RatchanonNRS/yaman_capstone/robot_ws/src/agv/meshes/link_R.STL

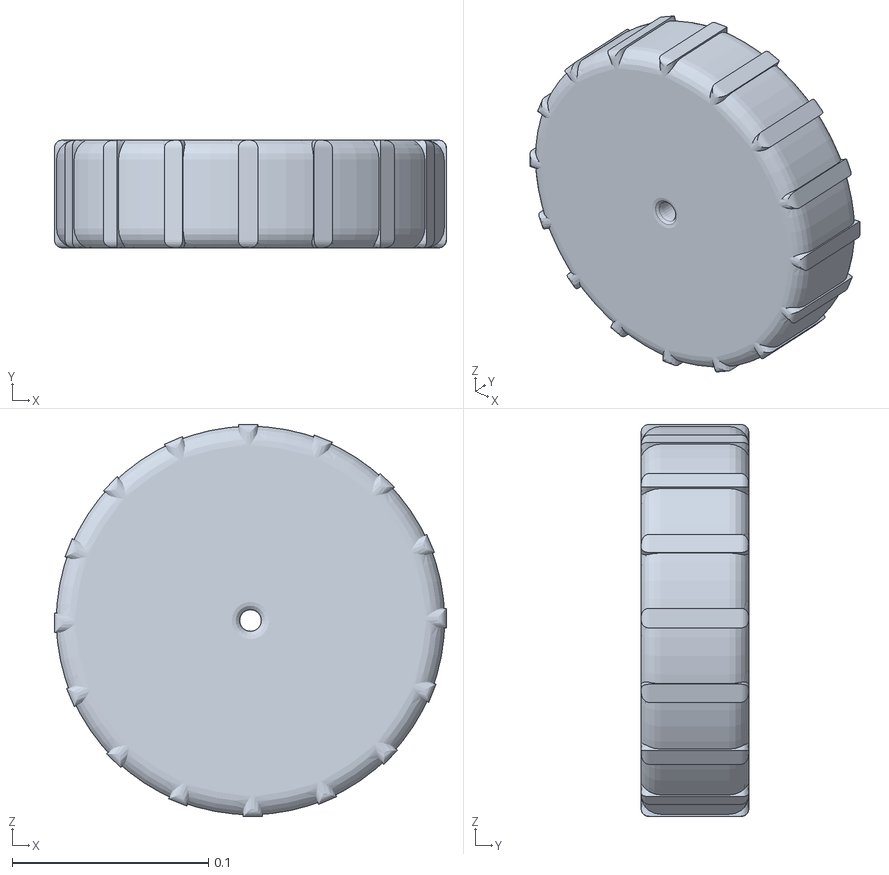
[picture p1: CAD file, 2026-03-16]
robot_ws/src/agv/meshes/link_R.STL
0.2 x 0.055 x 0.2
