RatchanonNRS/yaman_capstone/robot_ws/src/agv/meshes/LInk_lidar.STL

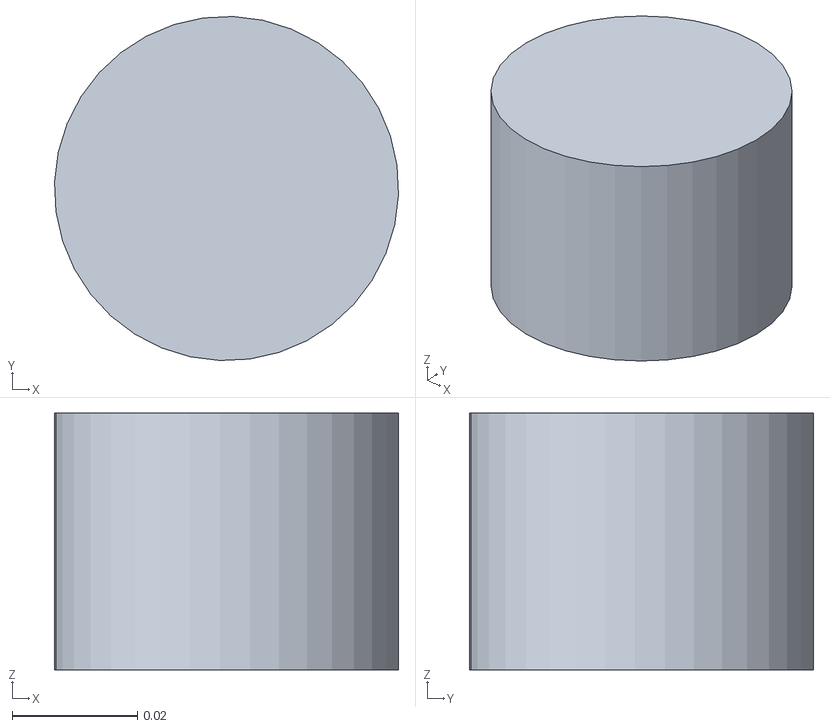
[picture p2: CAD file, 2026-03-16]
robot_ws/src/agv/meshes/LInk_lidar.STL
0.055 x 0.055 x 0.041
