RatchanonNRS/yaman_capstone/robot_ws/src/agv/meshes/base_link.STL

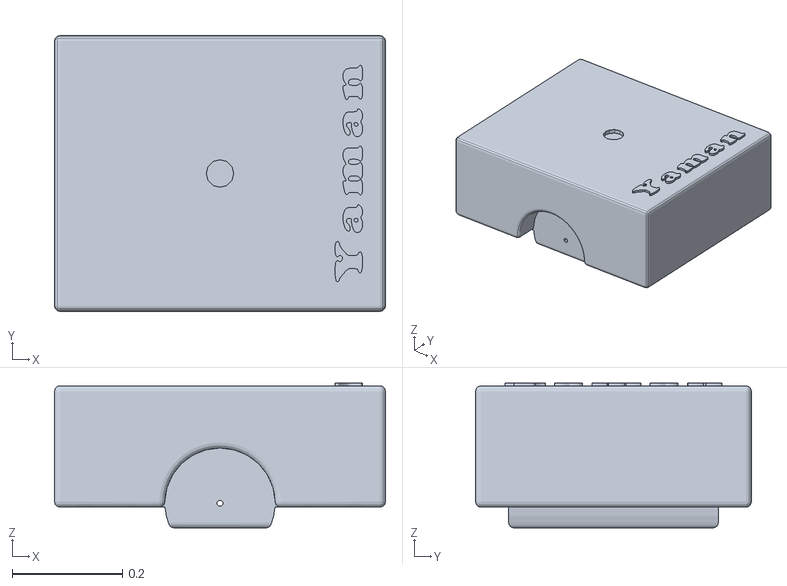
[picture p3: CAD file, 2026-03-16]
robot_ws/src/agv/meshes/base_link.STL
0.6 x 0.5 x 0.263
