RatchanonNRS/yaman_capstone/(list of files, cad)

Other CAD files:
robot_ws/src/agv/meshes/Link_L.STL
