RatchanonNRS/yaman_capstone/(commit log)

2026-03-16 add and modify files
    [LInk_lidar.STL, Link_L.STL, agv.csv, agv.urdf, base_link.STL, link_R.STL]
2026-03-16 Add BNO055 firmware, ROS2 packages, launch files, URDF fix, serial bridge
    [serial_bridge.py, yamancode.cpp]
2026-03-24 Move IMU from Arduino to RPi I2C
    - Add imu_node.py: reads MPU6050 via RPi I2C bus 1, publishes /imu/data at 50Hz
    - Remove IMU handling from serial_bridge.py (Arduino no longer has IMU)
    - Add imu_node to bringup.launch.py and setup.py entry points
    - Update CLAUDE.md to reflect new wiring, architecture, and session 3 changes
    [imu_node.py, serial_bridge.py]
2026-03-28 Session 3: IMU to RPi I2C, remove IMU from Arduino, SLAM lifecycle and param fixes
    [yamancode_sketch.ino]
2026-03-28 Session 4: fix slam_toolbox lifecycle auto-activation via TimerAction
2026-03-29 Session 4: log teleop direction bug as #1 priority for next session
    Robot moved wrong direction during teleop — could not save SLAM map.
    Added diagnostic steps and likely fixes to CLAUDE.md priority list.
2026-03-29 Session 5: fix teleop direction bug — DIR pins D22/D23, DIR logic, encoder signs
    [motor_test_sketch.ino, yamancode_sketch.ino]
2026-03-29 Session 6: mission integration, sequence protocol, PID fix
    - mission_node.py: straight-line shuttle GOING→SEQUENCING→RETURNING
    - serial_bridge.py: SEQ: protocol (sequence/command, sequence/status)
    - yamancode_sketch: mock sequence runner with vacuum retry (3 attempts)
    - slam_params: minimum_laser_range=0.40 to filter robot pillars
    - nav2_params: polygon footprint 50x60cm
    - agv.rviz: fix SetGoalPose → SetGoal tool name
    - CLAUDE.md + PROJECT_CONTEXT.md: full system overview updated
    - mission.launch.py: new launch file for shuttle mission
    [mission_node.py, serial_bridge.py, yamancode_sketch.ino]
2026-03-30 Session 7: investigate Nav2 backward motion — AMCL orientation ambiguity
    Root cause: AMCL gets 180° wrong in symmetric room. Lidar confirmed
    correctly mounted (rpy=0,0,0). Fix: remap room starting at HOME so
    map origin matches HOME position (0,0,yaw=0).
2026-03-30 Session 8: Nav2 1m forward drive verified, map remapped, params tuned
    - New map saved, agv_map.yaml origin adjusted: HOME = (-2.03, -0.51) in map frame
    - nav2_params: inflation 0.55→0.30, collision detection off, allow_reversing on,
    xy_goal_tolerance 0.25→0.05, local costmap static_layer only, footprint fixed
    - AMCL initial_pose set to HOME — no manual pose estimate needed at startup
    - CLAUDE.md: Session 8 notes, working guidelines for Yaman, Nav2 config table
2026-03-31 Fix brownout shutdown: remove active brake, lower Kp 500→200
    Active brake applied instant reverse PWM on goal stop, causing
    motor direction reversal spike that crashed the Pi 5 power supply.
    Kp lowered to 200 to reduce acceleration current draw.
    Also fix stale DIR pin comment (D52/D53 → D22/D23).
    [yamancode_sketch.ino]
2026-03-31 Session 9: PID brake tuning, fix brownout, tighten goal tolerance
    - Fix brownout: timer-based brake replaces active brake (no direction reversal spike)
    - Brake: 80 PWM, 500ms, fires on target transition (not repeated V:0,0)
    - Kp: 500→300, Ki: 50→20, Kd: 2→8, watchdog: 500→200ms
    - xy_goal_tolerance: 0.05→0.03m (source + installed)
    - Floor friction measured: 0.011 m/s², brake decel: 0.248 m/s²
    - 500ms brake brings robot from 0.10 m/s to ~0.022 m/s = 2-3cm coast
    - Add INFO:BRAKE debug print in startBrake() (for diagnostics)
    [yamancode_sketch.ino]
2026-03-31 Session 11: RViz fixed, GOING confirmed, SEQ:START bug found — robot at SHELF
2026-03-31 Session 13: round_trip_safe.py working, lidar ghost root cause found
    - round_trip_safe.py: full round trip 2.506m→shelf→2.623m→HOME confirmed ✅
    - Root cause of scan ghost: robot's own arm at 0.71m@0° in lidar scan
    - Fix: annular cone filter (±12° inner exclusion, ±20° outer) in obstacle check
    - MIN_POINTS=100 (scan effectively disabled for first test; set to 50 to enable)
    - Saved round_trip_safe.py to repo
    - CLAUDE.md updated with Session 13 findings, lidar scan anatomy, known issues
    [round_trip_safe.py]
2026-04-01 Lower brake PWM to 20/200ms, add SEQ:HB heartbeat in sequence, add EE dwell 1s
2026-04-01 Update CLAUDE.md: session 16 status, brake notes, sequence heartbeat
2026-04-01 Disable brake entirely (BRAKE_PWM=0) — was causing Pi brownout
    [yamancode_sketch.ino]
2026-04-01 Move EE homing to sequence start (3.5s), remove obstacle avoidance from mission_node
    [mission_node.py, sequence_hardware.h]
